FridleyTigersRobotics/SuitcaseCompressor/Altium_Air_compressor_pcb/CompressorPCB_BOM.xlsx

Bill of Material for CompressorPCB.PrjPCB
On 6/1/2024 at 7:43:45 PM
Comment | Pattern | Quantity | Components | Description | Digikey Part#
12PWR Header 2 (Male) | HDR1X2 | 1 | J1 | Header, 2-Pin | 2057-PH1-02-UA-ND (https://www.digikey.com/en/products/detail/adam-tech/PH1-02-UA/9830266)
AOD454A NMOS | TO252- no center pin | 2 | NM1, NM2 | N Channel FET | 785-1223-1-ND (https://www.digikey.com/en/products/detail/alpha-omega-semiconductor-inc/AOD454A/2353888)
Cap Semi 100 uF | CAPC3216L | 1 | C1 | Capacitor (Semiconductor SIM Model) | 490-16313-1-ND (https://www.digikey.com/en/products/detail/murata-electronics/GRM31CD80J107ME39K/7363057)
Cap Semi 10 uF | CAPC3216L | 1 | C2 | Capacitor (Semiconductor SIM Model) | 399-C1206C106M3PAC7800CT-ND (https://www.digikey.com/en/products/detail/kemet/C1206C106M3PAC7800/2215120)
Diode 11DQ03TR | DIO10.46-5.3x2.8 | 3 | D1, D2, D3 | 1 Amp Fast Recovery Rectifier | 1655-1893-1-ND (https://www.digikey.com/en/products/detail/smc-diode-solutions/11DQ03/7914874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)
Diode 1N5250B | DIO7.1-3.9x1.9 | 2 | ZD1, ZD2 | High Conductance Fast Diode | 1N5250B-ND (https://www.digikey.com/en/products/detail/onsemi/1N5250B/977615?s=N4IgTCBcDaIIwDkCsYkAYBCBaBAREAugL5A)
Header 12 (Female) | HDR1X12 | 2 | ArdL, ArdR | Header, 12-Pin | S7045-ND (https://www.digikey.com/en/products/detail/sullins-connector-solutions/PPPC121LFBN-RC/810184)
Header 12 (Male) | HDR1X12 | 2 | ArdLOUT, ArdROUT | Header, 12-Pin | 2057-PH1-12-UA-ND (https://www.digikey.com/en/products/detail/adam-tech/PH1-12-UA/9830395)
Res Semi 1k Ohm | RESC3216L | 2 | R1, R2 | Semiconductor Resistor | RMCF1206FT1K00CT-ND (https://www.digikey.com/en/products/detail/stackpole-electronics-inc/RMCF1206FT1K00/1759616)
Res Semi 1Meg Ohm | RESC3216L | 2 | R3, R4 | Semiconductor Resistor | RMCF1206JT1M00CT-ND (https://www.digikey.com/en/products/detail/stackpole-electronics-inc/RMCF1206JT1M00/1757505)
Res Semi 330 Ohm | RESC3216L | 1 | R5 | Semiconductor Resistor | RMCF1206FT330RCT-ND (https://www.digikey.com/en/products/detail/stackpole-electronics-inc/RMCF1206FT330R/1753952)
Res Semi 10k Ohm | RESC3216L | 1 | R6 | Semiconductor Resistor | RMCF1206FT10K0CT-ND (https://www.digikey.com/en/products/detail/stackpole-electronics-inc/RMCF1206FT10K0/1759669)
Res Axial 1Meg Ohm | AXIAL-0.3 | 1 | R7 | Resistor | 1.00MXBK-ND (https://www.digikey.com/en/products/detail/yageo/MFR-25FBF52-1M/13714) | Not the actual resistor used, but equivalent 1% tolerance
Res1 Axial 100k Ohm | AXIAL-0.3 | 1 | R8 | Resistor | 13-MFR-25FRF52-100KCT-ND (https://www.digikey.com/en/products/detail/yageo/MFR-25FRF52-100K/14630) | Not the actual resistor used, but equivalent 1% tolerance
TB1 | CONN_1935161_PXC | 1 | 12V | 2 position Terminal Block | 277-1667-ND (https://www.digikey.com/en/products/detail/phoenix-contact/1935161/568614?s=N4IgTCBcDa4OxwLQEYBsqkDkAiIC6AvkA)
TB2 | CONN_1935161_PXC | 1 | RSL | 2 position Terminal Block | 277-1667-ND (https://www.digikey.com/en/products/detail/phoenix-contact/1935161/568614?s=N4IgTCBcDa4OxwLQEYBsqkDkAiIC6AvkA)
TB3 | CONN_1935161_PXC | 1 | Compressor | 2 position Terminal Block | 277-1667-ND
TB4 | CONN_1935161_PXC | 1 | PressureSW | 2 position Terminal Block | 277-1667-ND
ZLDO1117G50TA | SOT223 | 1 | PW1 | 5V Linear Regulator | ZLDO1117G50DICT-ND (https://www.digikey.com/en/products/detail/diodes-incorporated/ZLDO1117G50TA/2095593)
Arduino Pro Mini | - | 1 |  | Plugs into ArdL and ArdR | 1568-1055-ND (https://www.digikey.com/en/products/detail/sparkfun-electronics/DEV-11113/5140820)
