FridleyTigersRobotics/SuitcaseCompressor/(list of files, drawings)

Other design files:
Altium_Air_compressor_pcb/compressorPCB.PcbDoc
Altium_Air_compressor_pcb/CompressorPCB.PrjPCB
Altium_Air_compressor_pcb/Footprints/ArduinoMiniPro/ArduinoMiniPro.PcbLib
Altium_Air_compressor_pcb/Footprints/ArduinoMiniPro/ArduinoMiniPro.SchLib
Altium_Air_compressor_pcb/Footprints/Button.PcbLib
Altium_Air_compressor_pcb/Footprints/Button.SchLib
Altium_Air_compressor_pcb/Footprints/compressorPCB.PcbDoc
Altium_Air_compressor_pcb/Footprints/custom cap/custom_cap.PcbLib
Altium_Air_compressor_pcb/Footprints/Inductor.PcbLib
Altium_Air_compressor_pcb/Footprints/Launcher/12GA Power Input.SchLib
Altium_Air_compressor_pcb/Footprints/Launcher/12GA Power Input_footprint.PcbLib
Altium_Air_compressor_pcb/Footprints/Launcher/30A Fuse Holder.SchLib
Altium_Air_compressor_pcb/Footprints/Launcher/64TQFPFootprint.PcbLib
Altium_Air_compressor_pcb/Footprints/Launcher/1206 Footprint.PcbLib
Altium_Air_compressor_pcb/Footprints/Launcher/Anderson Power 30Amp.PcbLib
Altium_Air_compressor_pcb/Footprints/Launcher/Anderson Power 30Amp.SchLib
Altium_Air_compressor_pcb/Footprints/Launcher/Anderson Power Dual 30Amp.PcbLib
Altium_Air_compressor_pcb/Footprints/Launcher/Anderson Power Dual 30Amp.SchLib
Altium_Air_compressor_pcb/Footprints/Launcher/AOD417 PMOS.SchLib
Altium_Air_compressor_pcb/Footprints/Launcher/AOD454A NMOS.SchLib
Altium_Air_compressor_pcb/Footprints/Launcher/Button.PcbLib
Altium_Air_compressor_pcb/Footprints/Launcher/Button.SchLib
Altium_Air_compressor_pcb/Footprints/Launcher/Custom Parts/Button.PcbLib
Altium_Air_compressor_pcb/Footprints/Launcher/Custom Parts/Button.SchLib
Altium_Air_compressor_pcb/Footprints/Launcher/Fuse Holder Footprint.PcbLib
Altium_Air_compressor_pcb/Footprints/Launcher/Launcher.SCHLIB
Altium_Air_compressor_pcb/Footprints/Launcher/LED.SchLib
Altium_Air_compressor_pcb/Footprints/Launcher/Linear Regulator SOT223.SchLib
Altium_Air_compressor_pcb/Footprints/Launcher/Linear Regulator TO252-3.SchLib
Altium_Air_compressor_pcb/Footprints/Launcher/PIC18F67K40-E_PT.SchLib
Altium_Air_compressor_pcb/Footprints/Launcher/SOI8_Level_shift.SchLib
Altium_Air_compressor_pcb/Footprints/Launcher/SOI8_Package.PcbLib
Altium_Air_compressor_pcb/Footprints/Launcher/SOT223Footprint.PcbLib
Altium_Air_compressor_pcb/Footprints/Launcher/TO252.PcbLib
Altium_Air_compressor_pcb/Footprints/Launcher/XT30.PcbLib
Altium_Air_compressor_pcb/Footprints/Launcher/XT30.SchLib
Altium_Air_compressor_pcb/Footprints/Launcher/XT60H-F.PcbLib
Altium_Air_compressor_pcb/Footprints/Launcher/XT60H-F.SchLib
Altium_Air_compressor_pcb/Footprints/LightControl.PcbLib
Altium_Air_compressor_pcb/Footprints/NMos.PcbLib
Altium_Air_compressor_pcb/Footprints/PCBfootprints_290709/Axial Lead Diode.PcbLib
Altium_Air_compressor_pcb/Footprints/PCBfootprints_290709/BGA_Rect.PcbLib
Altium_Air_compressor_pcb/Footprints/PCBfootprints_290709/BGA_Sq_40P.PcbLib
Altium_Air_compressor_pcb/Footprints/PCBfootprints_290709/BGA_Sq_50P.PcbLib
Altium_Air_compressor_pcb/Footprints/PCBfootprints_290709/BGA_Sq_65P.PcbLib
Altium_Air_compressor_pcb/Footprints/PCBfootprints_290709/BGA_Sq_75P.PcbLib
Altium_Air_compressor_pcb/Footprints/PCBfootprints_290709/BGA_Sq_80P.PcbLib
Altium_Air_compressor_pcb/Footprints/PCBfootprints_290709/BGA_Sq_150P.PcbLib
Altium_Air_compressor_pcb/Footprints/PCBfootprints_290709/Bridge Rectifier.PcbLib
Altium_Air_compressor_pcb/Footprints/PCBfootprints_290709/Bumpered QFP - Centre Index.PcbLib
Altium_Air_compressor_pcb/Footprints/PCBfootprints_290709/Bumpered QFP - Corner Index.PcbLib
Altium_Air_compressor_pcb/Footprints/PCBfootprints_290709/CAN - Circle pin arrangement.PcbLib
Altium_Air_compressor_pcb/Footprints/PCBfootprints_290709/CAN - Rectangle pin arrangement.PcbLib
Altium_Air_compressor_pcb/Footprints/PCBfootprints_290709/Capacitor Electrolytic Mount Ring.PcbLib
Altium_Air_compressor_pcb/Footprints/PCBfootprints_290709/Capacitor Electrolytic Snap-In.PcbLib
Altium_Air_compressor_pcb/Footprints/PCBfootprints_290709/Capacitor Non-Polar Axial.PcbLib
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
