FridleyTigersRobotics/SuitcaseCompressor/(commit log)

2024-05-30 fixed filename to match foldername for Arduino IDE compatibility
    [SuitcaseCompressor.ino]
2024-06-01 spelling correction on comments
    [SuitcaseCompressor.ino]
2024-06-02 initial commit of pcb design files
    [1206 Footprint.PcbLib, 12GA Power Input.SchLib, 12GA Power Input_footprint.PcbLib, 1935161.PcbLib, 1935161.SchLib, 30A Fuse Holder.SchLib, 64TQFPFootprint.PcbLib, AOD417 PMOS.SchLib]
